WilsonGuo23/Hand-Fan-Box/README.md

# Hand-Fan-Box

## Summary

This box converts the circular motion of a motor into angular motion, which is then used to wave a hand fan (or any other object you can attach to the lever). The speed can be adjusted using the knob on the fan controller. Connect to any USB outlet or power supply. Note that USB does not transfer enough power to lift objects heavier than a few grams.

## Parts required to assemble

- Manufacture the parts included in the PRINT_ME folder. All parts are single pieces except for the Ball Bearing to Ball Bearing Connector, which requires two, and the PCB Spacer, which requires four.

> **NOTE:** The .SLDPRT files can be opened in a cad program of your choice and edited before being exported. Certain openings may be adjusted by 0.3-0.5 millimeters to account for tolerances related to 3d printing, if you are using a more or less accurate medium you will likely want to adjust these values. You may also resize the .stl files in your slicer if you are using a 3D printer. the PRINT_ME_STLs folder will have the stl files if you do not want to go through and export each part from your CAD program of choice.

- X4 *[M3 10mm Coupling Nuts](https://www.amazon.com/dp/B0FY366GRH?ref=ppx_yo2ov_dt_b_fed_asin_title&th=1)*

- X8 M3x35mm Screws

> **NOTE:** Be sure that your 35mm screws are compatible with the coupling nuts.

- X2 M3x10mm Screws

- X2 M3x8mm Screws

- X3 M3x30mm Screws

- X4 M3x16mm Screws

- X11 M3 Bolts

- X1 *[USB Passthrough](https://www.amazon.com/dp/B09VGK89XP?th=1)*

- X1 *[This Motor Controller](placeholder)*

> **NOTE:** "We have motor controllers at home" -me, feel free to change this to something else. if you do, be sure to adjust the four mounting holes on the Fan Motor Back Panel file. You will also need this *[rocker switch](https://www.amazon.com/DaierTek-250VAC-Rocker-KCD1-101-Plastic/dp/B07S2QJKTX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)*.

- X1 *[This Motor](https://www.amazon.com/dp/B099Z85573)*

> **NOTE:** You could use a different motor but you will need to change the Fan Motor Mounting Bracket file to accommodate it. If the motor is too large you, will also need to adjust the Fan Box Cover First Half and Second Half files. You may also need to adjust the Fan Motor Back Panel file.

- X3 *[608-2RS Ball Bearings](https://www.amazon.com/dp/B09PKD8QZZ?th=1)*

- Screwdriver(s) (dependent on what screws you use)

- x1 Hand Fan

- X2-5 Zipties

## How to Assemble

1. Insert a ball bearing into the mounting bracket ball bearing cover.

Fanbox_Step_1

2. Use 2 M3x10mm screws and 2 bolts to attach the mounting bracket ball bearing cover to the mounting bracket, then attach the motor to the mounting bracket with 3 M3x30mm screws and 3 bolts on the opposite side.

Fanbox_Step_2_1

Fanbox_Step_2_2

3. Attach the fan box cover first half to the mounting bracket on the side of the motor using 4 M3x35mm screws and 4 M3x10mm coupling nuts.

Fanbox_Step_3

4. Attach the motor controller to the fan motor back panel with the adjustment knob facing outward. You will use 4 M3x16mm screws, 4 PCB spacers, and 4 bolts. Then screw in the USB passthrough on the opposite side and plug the USB power cable into the USB passthrough.

> **NOTE:** It may also be worth cutting the included USB power cable shorter to avoid clearance issues later.

Fanbox_Step_4

5. Slide the motor controller control knob into the fan cover second half so that the four screw holes are aligned and the rocker switch gap is facing away from the fan motor back plate. Place 4 M3x35mm screws in the screw holes connecting the back panel to the cover second half. Then place the rocker switch in the gap at the top of the fan cover second half. 

Fanbox_Step_5

6. Strip the motor power wires and screw them into the appropriate screw terminals. Power the device briefly to ensure the wiring is correct. Place the 2 fan cover halves together and twist in the 4 screws on the back panel side.

Fanbox_Step_6_2

Fanbox_Step_6

7. Place the motor to ball bearing connector on the motor and insert the bottom of the fan lever into the ball bearing held in place by the ball bearing cover.

Fanbox_Step_7

8. Place 2 ball bearings in one half of the ball bearing to ball bearing connector, then cover with the other half and seal shut with 2 M3x8mm screws and 2 bolts.

Fanbox_Step_8

Fanbox_Step_8_2

9. Attach a fan to the fan lever using zip ties and connect the completed ball bearing to ball bearing connector to the motor to ball bearing part and the fan lever.

Fanbox_Step_9
