WilsonGuo23/Hand-Fan-Box/Defunct/Fan Test Fit Panel.SLDPRT

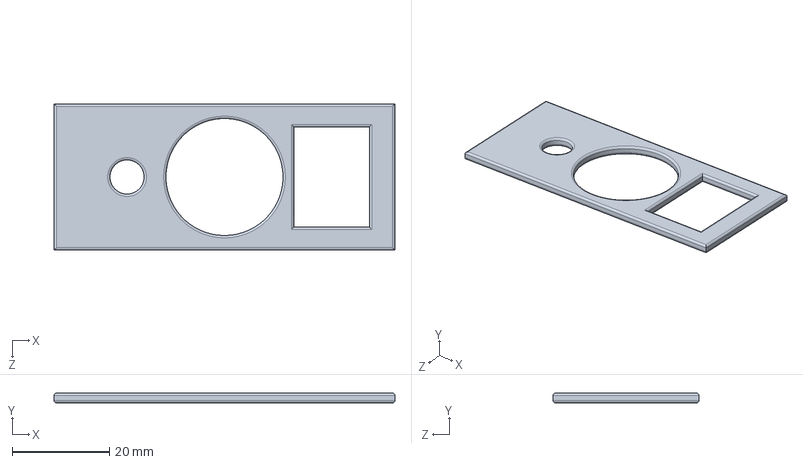
[picture p1: CAD file, 2026-03-05]
Defunct/Fan Test Fit Panel.SLDPRT
70.0 x 2.00 x 30.0 mm
