WilsonGuo23/Hand-Fan-Box/PRINT_ME/PCB Spacer.SLDPRT

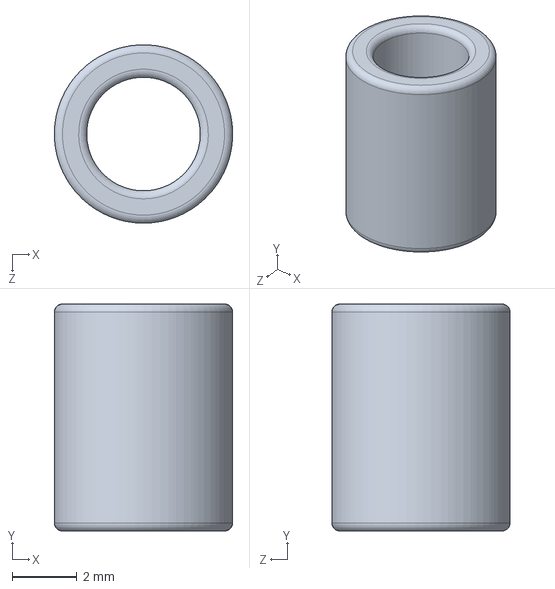
[picture p2: CAD file, 2026-03-09]
PRINT_ME/PCB Spacer.SLDPRT
5.50 x 7.00 x 5.50 mm
