WilsonGuo23/Hand-Fan-Box/Defunct/Pin Cover.SLDPRT

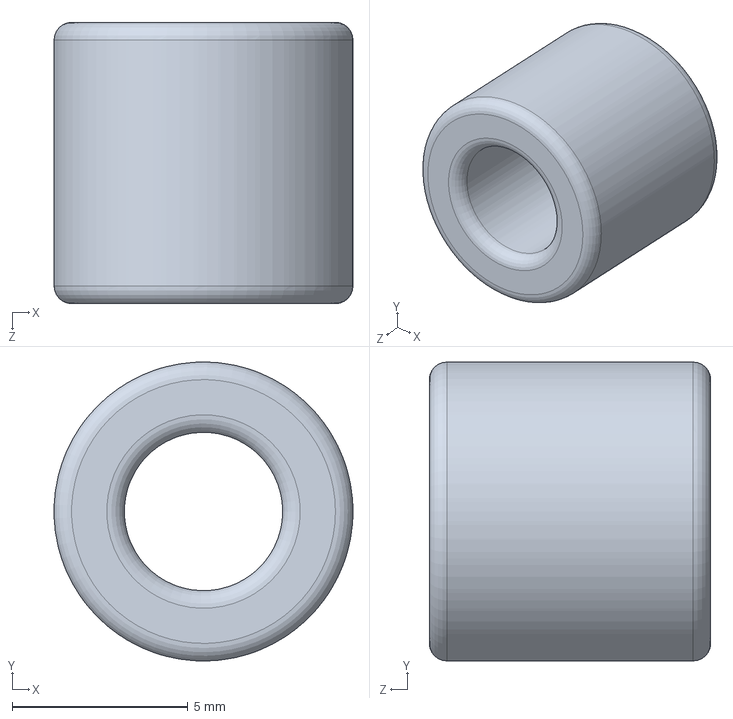
[picture p3: CAD file, 2026-03-05]
Defunct/Pin Cover.SLDPRT
8.50 x 8.50 x 8.00 mm
