WilsonGuo23/Hand-Fan-Box/PRINT_ME/Fan Box Cover Second Half.SLDPRT

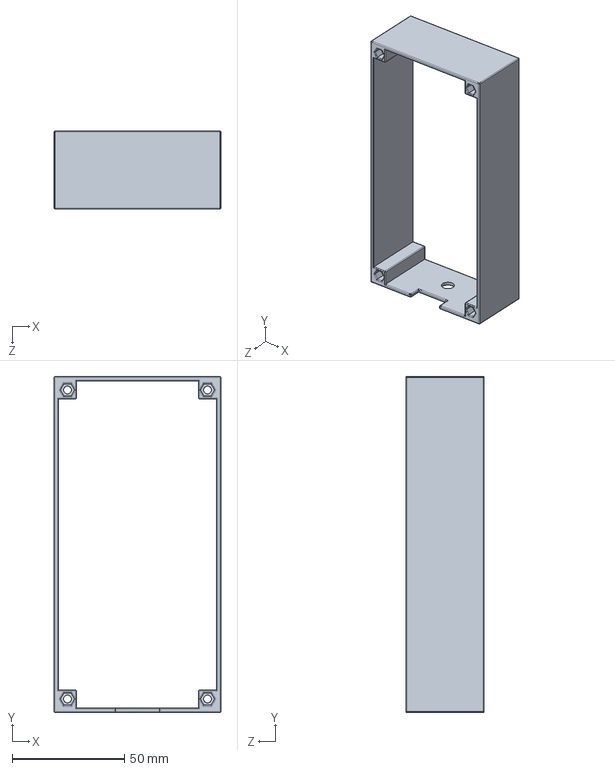
[picture p4: CAD file, 2026-03-09]
PRINT_ME/Fan Box Cover Second Half.SLDPRT
74.5 x 150.0 x 35.0 mm
