WilsonGuo23/Hand-Fan-Box/Defunct/608 Steel Ball Bearing.SLDPRT

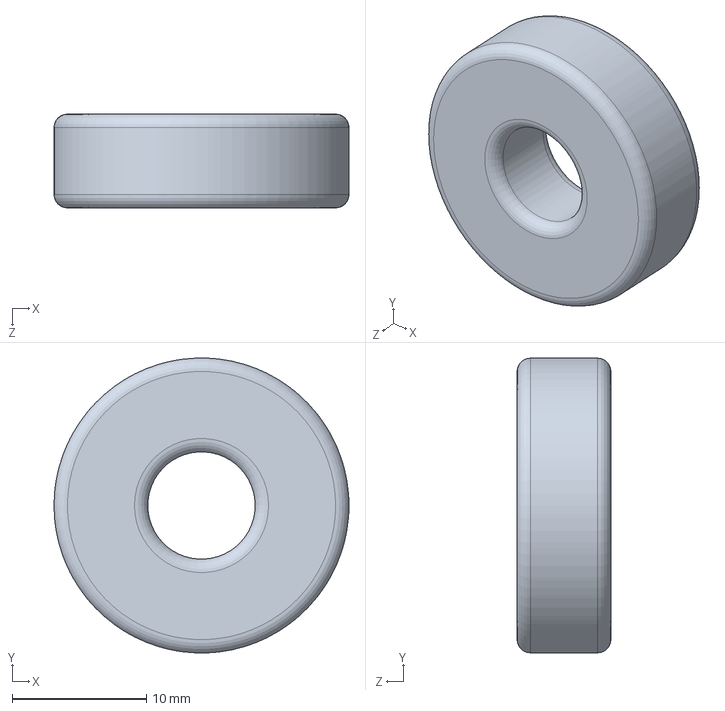
[picture p5: CAD file, 2026-03-05]
Defunct/608 Steel Ball Bearing.SLDPRT
22.0 x 22.0 x 7.00 mm
