WilsonGuo23/Hand-Fan-Box/PRINT_ME/Fan Lever.SLDPRT

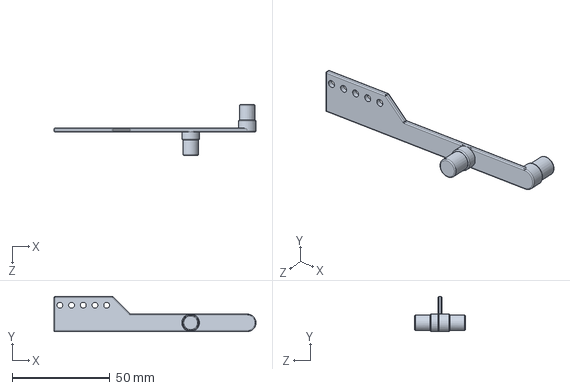
[picture p6: CAD file, 2026-03-09]
PRINT_ME/Fan Lever.SLDPRT
103.5 x 18.0 x 26.0 mm
