WilsonGuo23/Hand-Fan-Box/PRINT_ME/Fan Motor Back Panel.SLDPRT

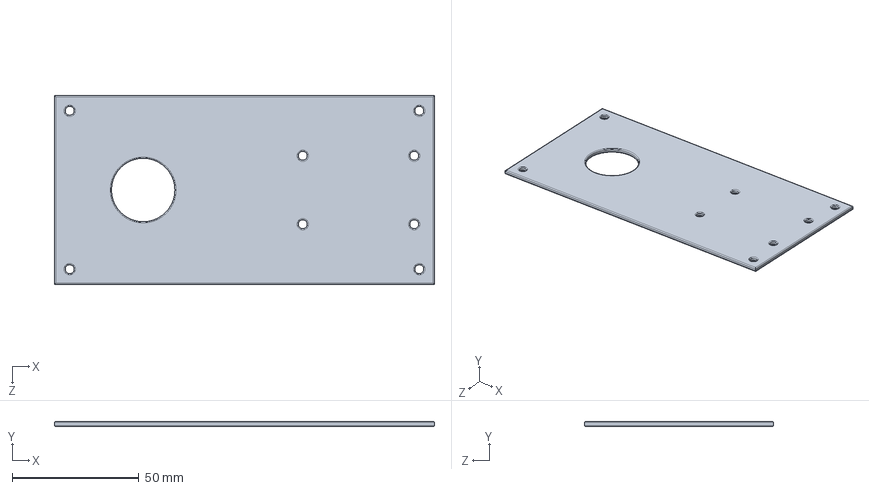
[picture p7: CAD file, 2026-03-09]
PRINT_ME/Fan Motor Back Panel.SLDPRT
150.0 x 2.00 x 74.5 mm
