WilsonGuo23/Hand-Fan-Box/Defunct/Weight Tray.SLDPRT

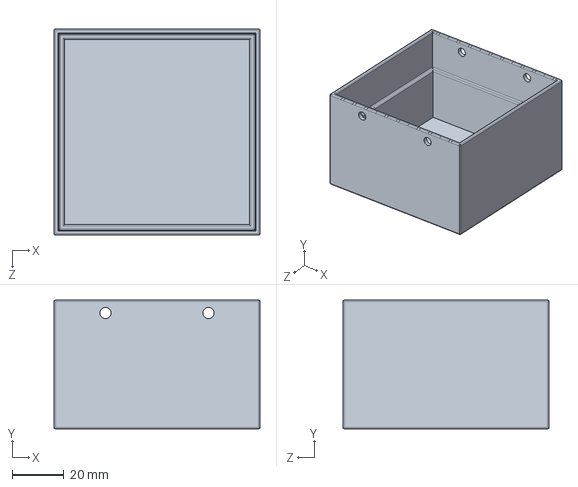
[picture p8: CAD file, 2026-03-05]
Defunct/Weight Tray.SLDPRT
80.0 x 50.0 x 80.0 mm
