WilsonGuo23/Hand-Fan-Box/PRINT_ME/Mounting Bracket Ball Bearing Cover.SLDPRT

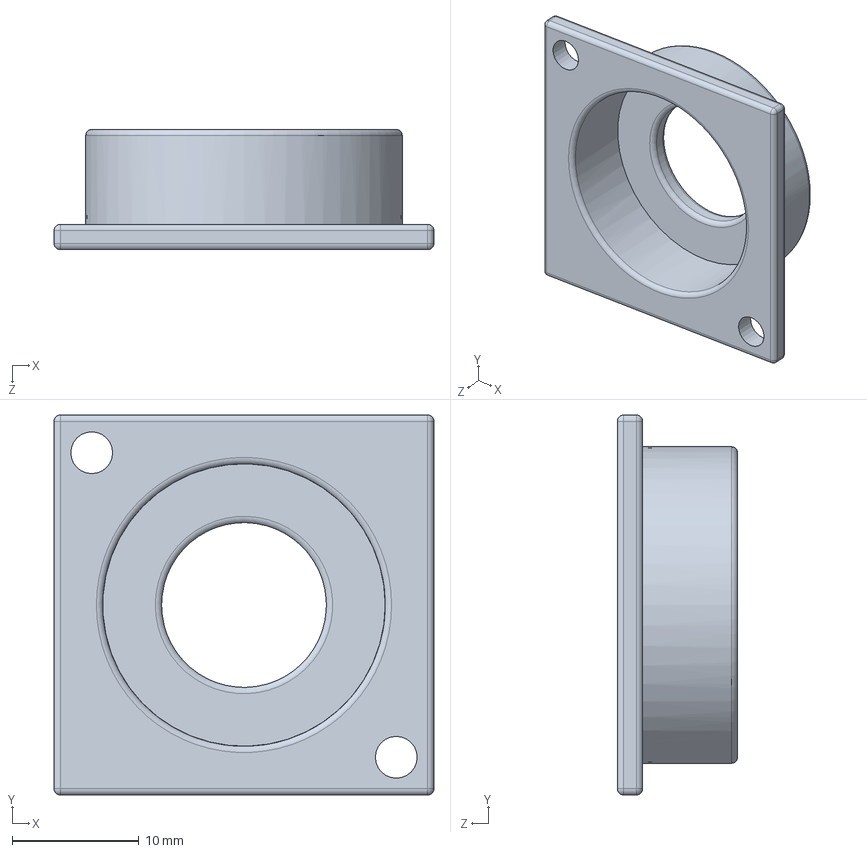
[picture p9: CAD file, 2026-03-05]
PRINT_ME/Mounting Bracket Ball Bearing Cover.SLDPRT
30.0 x 30.0 x 9.50 mm
