WilsonGuo23/Hand-Fan-Box/PRINT_ME/Ball Bearing to Ball Bearing Connector.SLDPRT

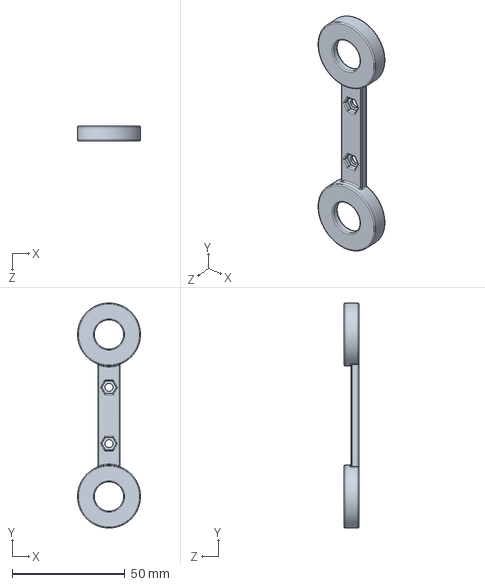
[picture p10: CAD file, 2026-03-05]
PRINT_ME/Ball Bearing to Ball Bearing Connector.SLDPRT
28.0 x 100.0 x 6.55 mm
