WilsonGuo23/Hand-Fan-Box/PRINT_ME/Motor to Ball Bearing.SLDPRT

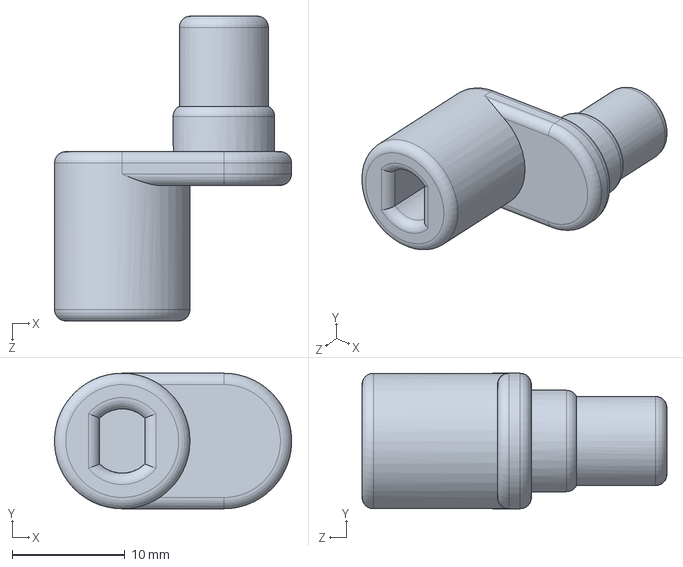
[picture p11: CAD file, 2026-03-05]
PRINT_ME/Motor to Ball Bearing.SLDPRT
21.0 x 12.0 x 27.0 mm
