WilsonGuo23/Hand-Fan-Box/PRINT_ME/Fan Motor Mounting Bracket.SLDPRT

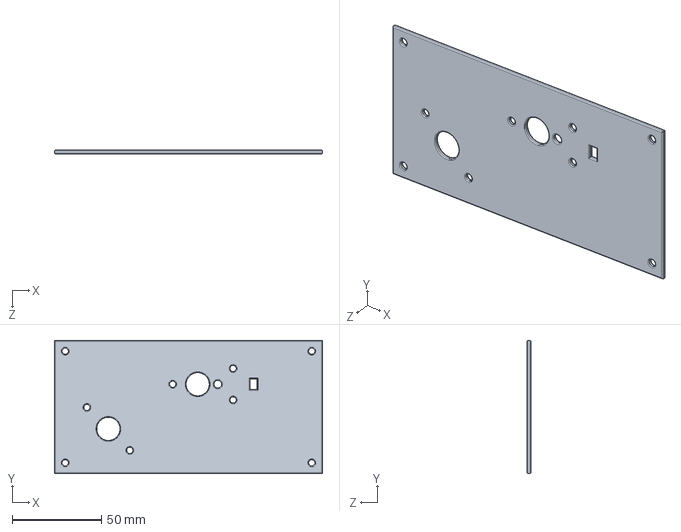
[picture p12: CAD file, 2026-03-05]
PRINT_ME/Fan Motor Mounting Bracket.SLDPRT
150.0 x 74.5 x 2.00 mm
