WilsonGuo23/Hand-Fan-Box/(list of files, cad)

Other CAD files:
Defunct/Fan Box Cover.SLDPRT
PRINT_ME/Fan Box Cover First Half.SLDPRT
PRINT_ME_STLs/Fan Lever.STL
PRINT_ME_STLs/Fan Motor Back Panel.STL
PRINT_ME_STLs/Motor to Ball Bearing.STL
PRINT_ME_STLs/PCB Spacer.STL
