WilsonGuo23/Hand-Fan-Box/(commit log)

2026-03-05 Importing work
    see above
    [608 Steel Ball Bearing.SLDPRT, Ball Bearing to Ball Bearing Connector.SLDPRT, Fan Box Cover First Half.SLDPRT, Fan Box Cover Second Half.SLDPRT, Fan Box Cover.SLDPRT, Fan Lever.SLDPRT, Fan Motor Back Panel.SLDPRT, Fan Motor Mounting Bracket.SLDPRT]
2026-03-06 Enhance README with assembly details and parts list
    Added detailed assembly instructions and parts list to README.
2026-03-09 Reworked Folder Structure
    Reworked the folder structure and made some changes to the fan lever and motor to ball bearing part
    [608 Steel Ball Bearing.SLDPRT, Ball Bearing to Ball Bearing Connector.SLDPRT, Fan Box Cover First Half.SLDPRT, Fan Box Cover Second Half.SLDPRT, Fan Box Cover.SLDPRT, Fan Lever.SLDPRT, Fan Lever.STL, Fan Motor Back Panel.SLDPRT]
2026-03-09 Revise README with detailed assembly parts and notes
    Updated assembly instructions and parts list for clarity.
2026-03-09 Final Part update of this version
    Created PCB spacer, dimensioned fan speed nub hole (no idea why it didn't already have one)
    [Fan Box Cover Second Half.SLDPRT, PCB Spacer.SLDPRT, PCB Spacer.STL]
2026-03-12 Update README with assembly instructions and parts list
    Added assembly steps and updated components list in README.
